natehouk/SS-VCO-1/(list of files, drawings)

Other design files:
AS3340-VCO.dsn
