natehouk/SS-VCO-1/AS3340-VCO.kicad_pcb

## KiCad design AS3340-VCO.kicad_pcb (2020-11-25)

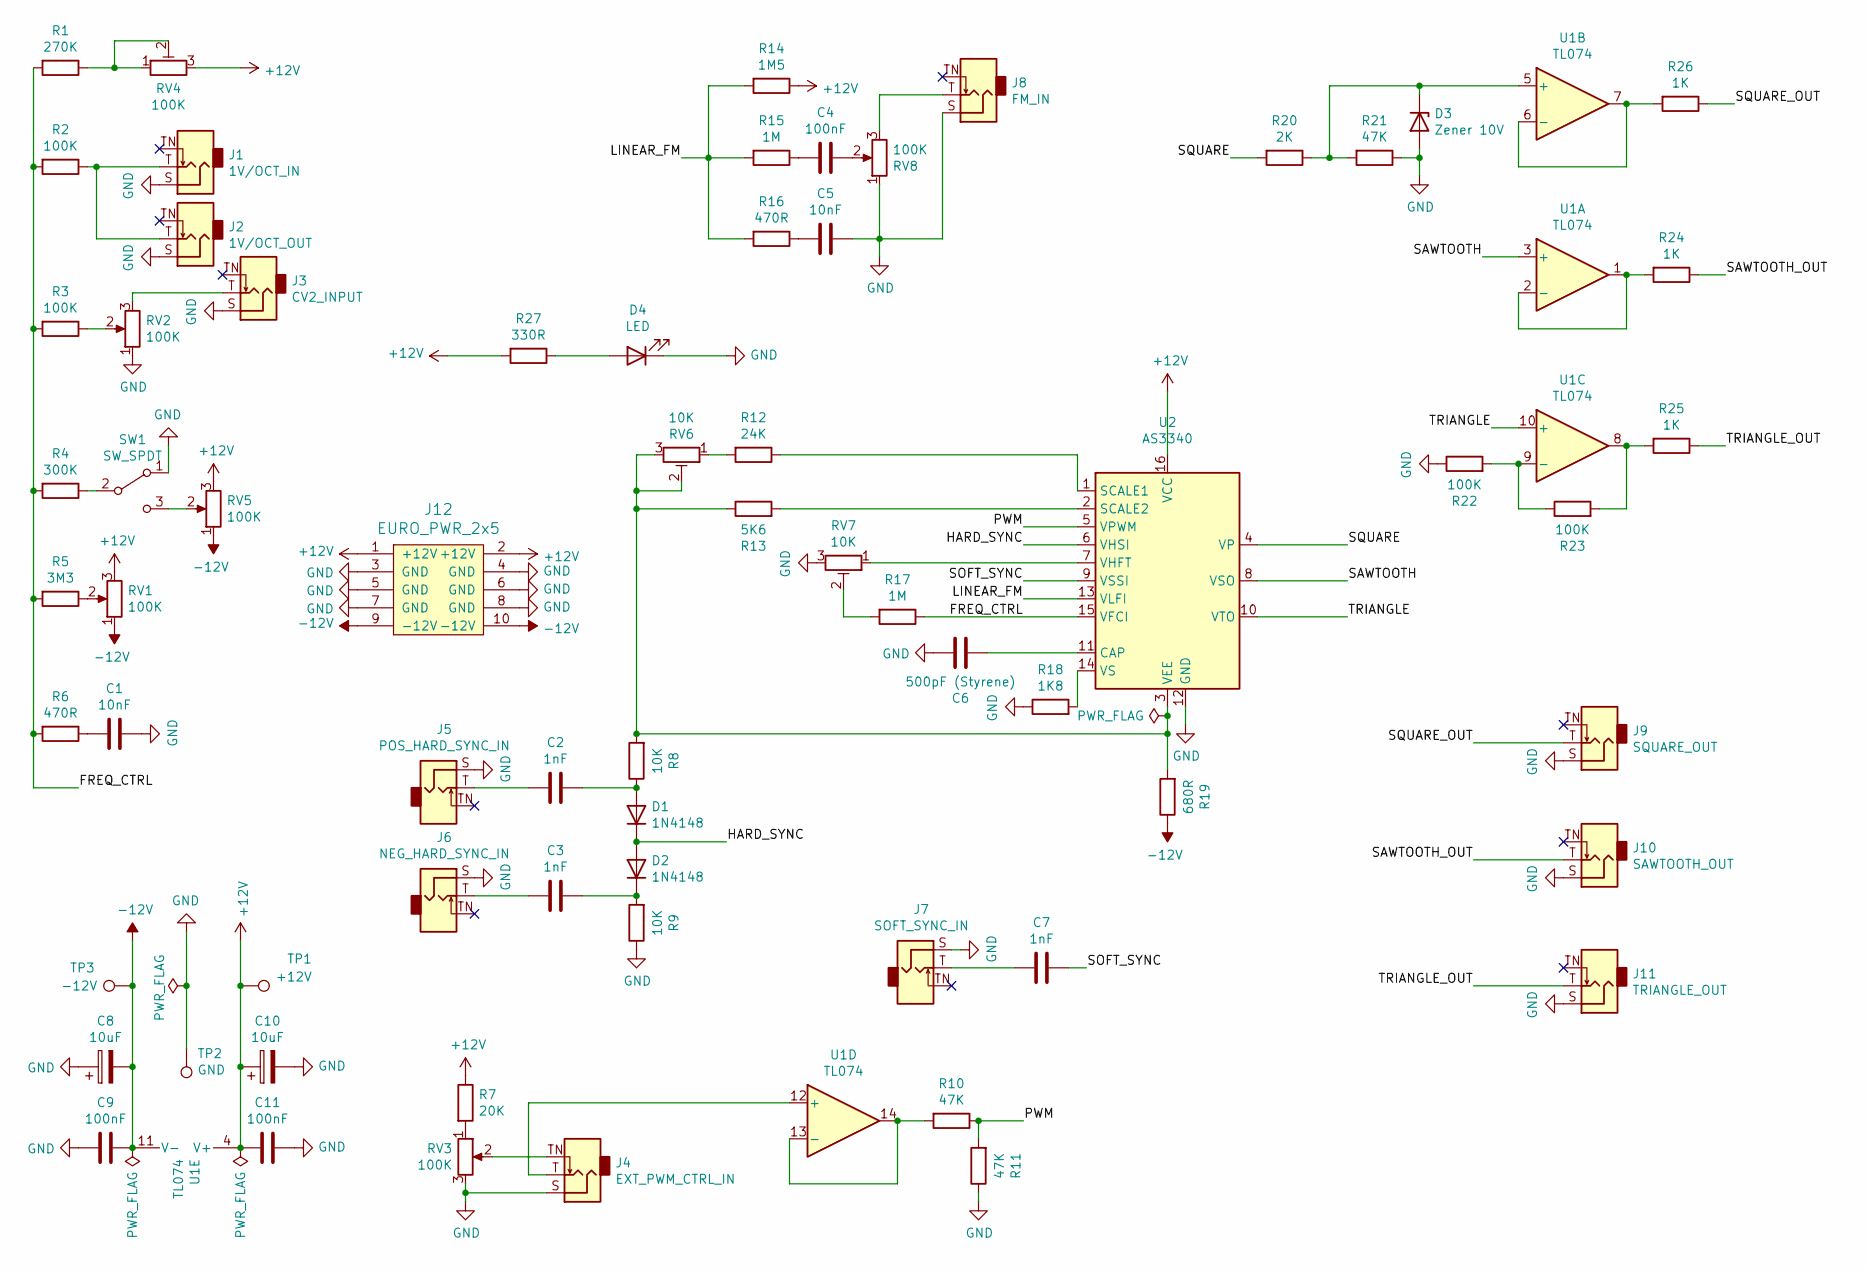
[picture p1: schematic AS3340-VCO.sch, SS-VCO-1]

Parts:
C1, C5: 10nF; C_Disc_D7.5mm_W2.5mm_P5.00mm
C2, C3, C7: 1nF; C_Disc_D7.5mm_W2.5mm_P5.00mm
C4, C9, C11: 100nF; C_Disc_D7.5mm_W2.5mm_P5.00mm
C6: 500pF (Styrene); C_Disc_D7.5mm_W2.5mm_P5.00mm
C8, C10: 10uF; CP_Radial_D5.0mm_P2.50mm
D1, D2: 1N4148; D_DO-35_SOD27_P7.62mm_Horizontal
D3: Zener 10V; D_DO-35_SOD27_P7.62mm_Horizontal
D4: LED; LED_D5.0mm
J1: 1V/OCT_IN; Jack_3.5mm_QingPu_WQP-PJ398SM_Vertical_CircularHoles
J2: 1V/OCT_OUT; Jack_3.5mm_QingPu_WQP-PJ398SM_Vertical_CircularHoles
J3: CV2_INPUT; Jack_3.5mm_QingPu_WQP-PJ398SM_Vertical_CircularHoles
J4: EXT_PWM_CTRL_IN; Jack_3.5mm_QingPu_WQP-PJ398SM_Vertical_CircularHoles
J5: POS_HARD_SYNC_IN; Jack_3.5mm_QingPu_WQP-PJ398SM_Vertical_CircularHoles
J6: NEG_HARD_SYNC_IN; Jack_3.5mm_QingPu_WQP-PJ398SM_Vertical_CircularHoles
J7: SOFT_SYNC_IN; Jack_3.5mm_QingPu_WQP-PJ398SM_Vertical_CircularHoles
J8: FM_IN; Jack_3.5mm_QingPu_WQP-PJ398SM_Vertical_CircularHoles
J9: SQUARE_OUT; Jack_3.5mm_QingPu_WQP-PJ398SM_Vertical_CircularHoles
J10: SAWTOOTH_OUT; Jack_3.5mm_QingPu_WQP-PJ398SM_Vertical_CircularHoles
J11: TRIANGLE_OUT; Jack_3.5mm_QingPu_WQP-PJ398SM_Vertical_CircularHoles
J12: EURO_PWR_2x5; 3M_2510-6002UB
R1: 270K; R_Axial_DIN0207_L6.3mm_D2.5mm_P10.16mm_Horizontal
R2, R3, R22, R23: 100K; R_Axial_DIN0207_L6.3mm_D2.5mm_P10.16mm_Horizontal
R4: 300K; R_Axial_DIN0207_L6.3mm_D2.5mm_P10.16mm_Horizontal
R5: 3M3; R_Axial_DIN0207_L6.3mm_D2.5mm_P10.16mm_Horizontal
R6, R16: 470R; R_Axial_DIN0207_L6.3mm_D2.5mm_P10.16mm_Horizontal
R7: 20K; R_Axial_DIN0207_L6.3mm_D2.5mm_P10.16mm_Horizontal
R8, R9: 10K; R_Axial_DIN0207_L6.3mm_D2.5mm_P10.16mm_Horizontal
R10, R11, R21: 47K; R_Axial_DIN0207_L6.3mm_D2.5mm_P10.16mm_Horizontal
R12: 24K; R_Axial_DIN0207_L6.3mm_D2.5mm_P10.16mm_Horizontal
R13: 5K6; R_Axial_DIN0207_L6.3mm_D2.5mm_P10.16mm_Horizontal
R14: 1M5; R_Axial_DIN0207_L6.3mm_D2.5mm_P10.16mm_Horizontal
R15, R17: 1M; R_Axial_DIN0207_L6.3mm_D2.5mm_P10.16mm_Horizontal
R18: 1K8; R_Axial_DIN0207_L6.3mm_D2.5mm_P10.16mm_Horizontal
R19: 680R; R_Axial_DIN0207_L6.3mm_D2.5mm_P10.16mm_Horizontal
R20: 2K; R_Axial_DIN0207_L6.3mm_D2.5mm_P10.16mm_Horizontal
R24, R25, R26: 1K; R_Axial_DIN0207_L6.3mm_D2.5mm_P10.16mm_Horizontal
R27: 330R; R_Axial_DIN0207_L6.3mm_D2.5mm_P10.16mm_Horizontal
RV1, RV2, RV3, RV5, RV8: 100K; Potentiometer_Alpha_RD901F-40-00D_Single_Vertical
RV4: 100K; TRIM_3266W-1-102LF
RV6, RV7: 10K; TRIM_3266W-1-102LF
SW1: SW_SPDT; SW_Toggle_Blue_wSlots
TP1: +12V; TestPoint_Pad_4.0x4.0mm
TP2: GND; TestPoint_Pad_4.0x4.0mm
TP3: -12V; TestPoint_Pad_4.0x4.0mm
U1: TL074; DIP-14_W7.62mm_Socket
U2: AS3340; DIP-16_W7.62mm_Socket

Connections:
+12V: C10.1, C11.2, J12.1 (+12V), J12.2 (+12V), R7.1, R14.1, R27.2, RV1.3, RV4.3, RV5.3, TP1.1, U1.4 (V+), U2.16 (VCC)
-12V: C8.2, C9.1, J12.9 (-12V), J12.10 (-12V), R19.1, RV1.1, RV5.1, TP3.1, U1.11 (V-)
/FREQ_CTRL: R1.2, R2.2, R3.2, R4.2, R5.2, R6.2, R17.1, U2.15 (VFCI)
/HARD_SYNC: D1.1 (K), D2.2 (A), U2.6 (VHSI)
/LINEAR_FM: R14.2, R15.2, R16.2, U2.13 (VLFI)
/PWM: R10.1, R11.2, U2.5 (VPWM)
/SAWTOOTH: U1.3 (+), U2.8 (VSO)
/SAWTOOTH_OUT: J10.T, R24.1
/SOFT_SYNC: C7.1, U2.9 (VSSI)
/SQUARE: R20.2, U2.4 (VP)
/SQUARE_OUT: J9.T, R26.1
/TRIANGLE: U1.10 (+), U2.10 (VTO)
/TRIANGLE_OUT: J11.T, R25.1
GND: C1.1, C5.1, C6.1, C8.1, C9.2, C10.2, C11.1, D3.2 (A), D4.1 (K), J1.S, J2.S, J3.S, J4.S, J5.S, J6.S, J7.S, J8.S, J9.S, J10.S, J11.S, J12.3 (GND), J12.4 (GND), J12.5 (GND), J12.6 (GND), J12.7 (GND), J12.8 (GND), R9.1, R11.1, R18.1, R21.1, R22.1, RV2.1, RV3.3, RV7.3, RV8.1, SW1.1 (A), TP2.1, U2.12 (GND)
unnamed: C1.2, R6.1
unnamed: C2.1, D1.2 (A), R8.1
unnamed: C2.2, J5.T
unnamed: C3.1, D2.1 (K), R9.2
unnamed: C3.2, J6.T
unnamed: C4.1, RV8.2
unnamed: C4.2, R15.1
unnamed: C5.2, R16.1
unnamed: C6.2, U2.11 (CAP)
unnamed: C7.2, J7.T
unnamed: D3.1 (K), R20.1, R21.2, U1.5 (+)
unnamed: D4.2 (A), R27.1
unnamed: J1.T, J2.T, R2.1
unnamed: J3.T, RV2.3
unnamed: J4.T, U1.12 (+)
unnamed: J4.TN, RV3.2
unnamed: J8.T, RV8.3
unnamed: R1.1, RV4.1, RV4.2
unnamed: R3.1, RV2.2
unnamed: R4.1, SW1.2 (B)
unnamed: R5.1, RV1.2
unnamed: R7.2, RV3.1
unnamed: R10.2, U1.13 (-), U1.14
unnamed: R12.1, U2.1 (SCALE1)
unnamed: R12.2, RV6.1
unnamed: R8.2, R13.1, R19.2, RV6.2, RV6.3, U2.3 (VEE)
unnamed: R13.2, U2.2 (SCALE2)
unnamed: R17.2, RV7.2
unnamed: R18.2, U2.14 (VS)
unnamed: R22.2, R23.1, U1.9 (-)
unnamed: R23.2, R25.2, U1.8
unnamed: R24.2, U1.1, U1.2 (-)
unnamed: R26.2, U1.6 (-), U1.7
unnamed: RV5.2, SW1.3 (C)
unnamed: RV7.1, U2.7 (VHFT)

Board: 2 copper layers, 72 parts (18 on the bottom side), 49 nets, no tracks yet.

Other parts of the board:
BOTTOM_LEFT_MOUNT: MountingHole_3.2mm_M3_Oval
BOTTOM_RIGHT_MOUNT: MountingHole_3.2mm_M3_Oval
TOP_LEFT_MOUNT: MountingHole_3.2mm_M3_Oval
TOP_RIGHT_MOUNT: MountingHole_3.2mm_M3_Oval
